samahsheeha1/Milkshake-machine-Hardware-graduation-project-/images/4.png

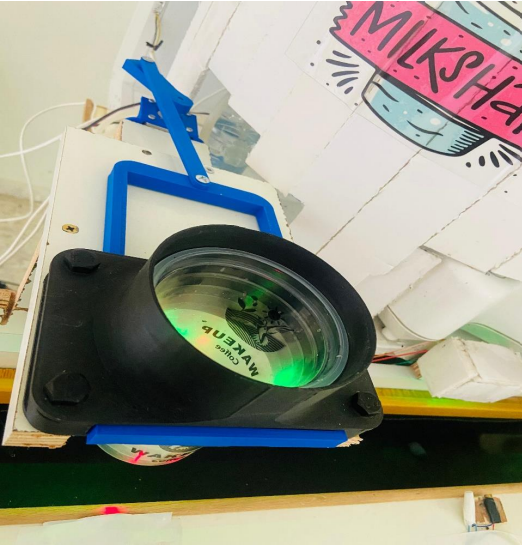
images/4.png
