samahsheeha1/Milkshake-machine-Hardware-graduation-project-/images/1.png

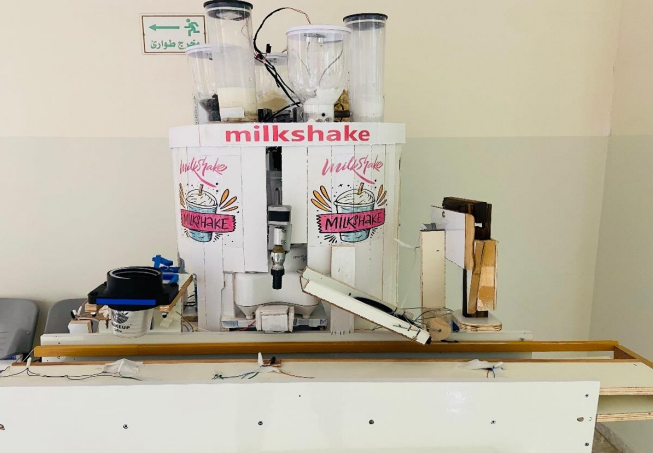
images/1.png
