samahsheeha1/Milkshake-machine-Hardware-graduation-project-/images/2.png

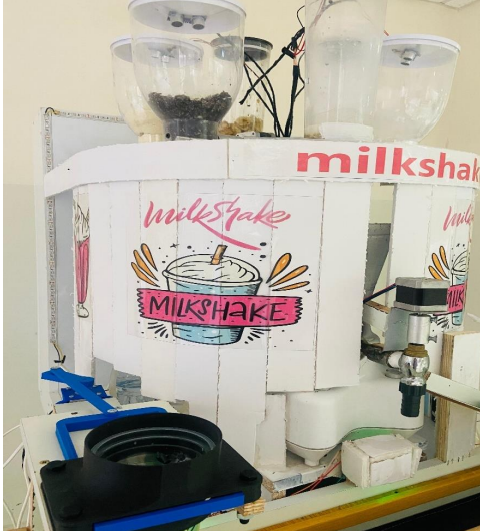
images/2.png
