samahsheeha1/Milkshake-machine-Hardware-graduation-project-/images/3.png

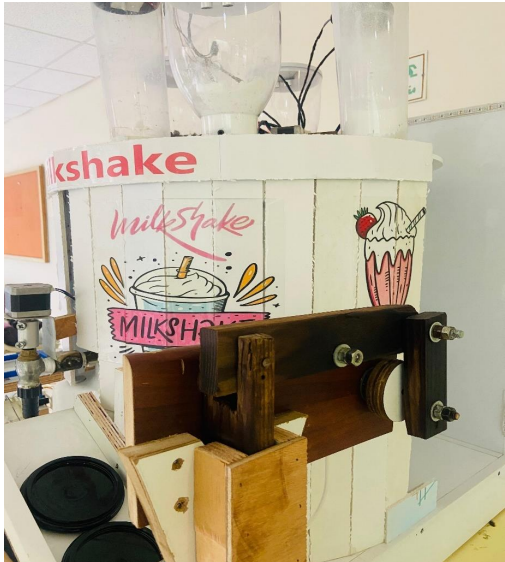
images/3.png
