samahsheeha1/Milkshake-machine-Hardware-graduation-project-/images/5.png

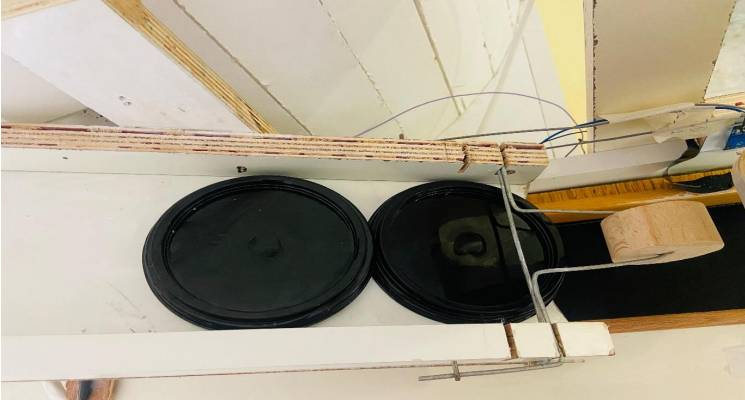
images/5.png
