samahsheeha1/Milkshake-machine-Hardware-graduation-project-/images/6.png

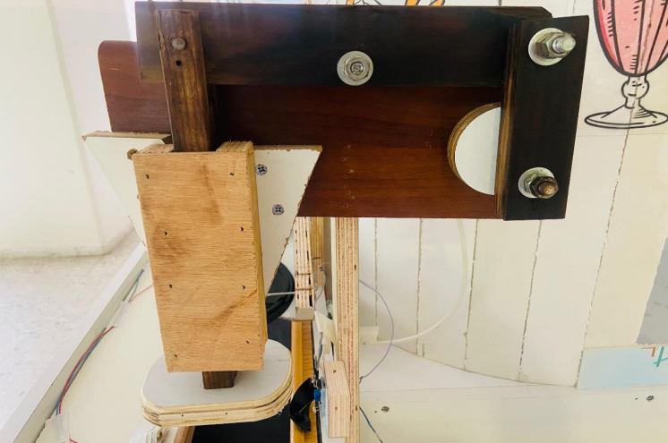
images/6.png
